wldd22/dodeca-card/images/pcb_back.png

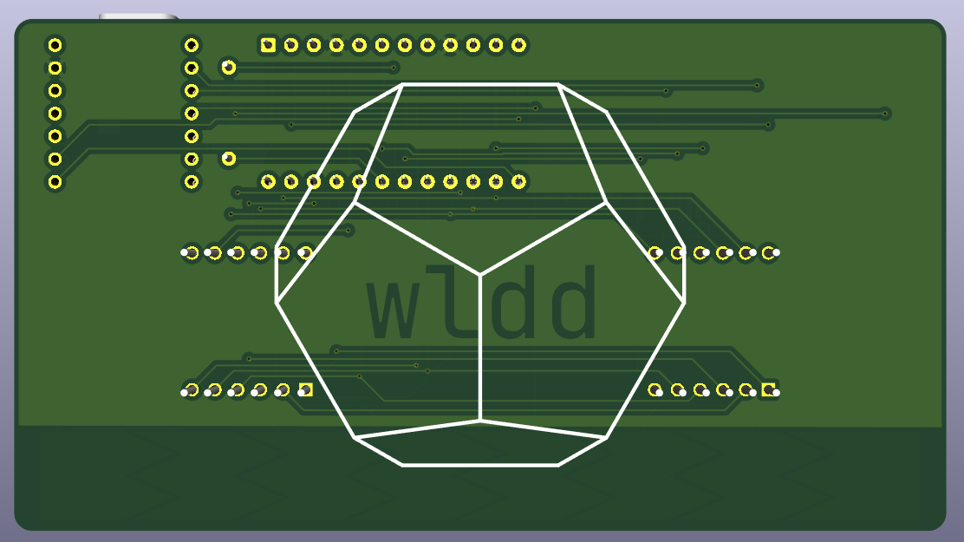
images/pcb_back.png
