wldd22/dodeca-card/BOM.csv

Item | Qty | Supplier | Cost/item | Total Cost | link
PCB | 1 | JLCPCB | $6.90 | $6.90 | https://jlcpcb.com/
MCMF006FF3002A50 30kΩ Through Hole Resistor | 11 | Robu | $0.01 | $0.11 | https://robu.in/product/mcmf006ff3002a50-multicomp-pro-through-hole-resistor-30-kohm-mcmf-series-600-mw-%C2%B1-1-axial-leaded-250-v/
MAX7219-HLF-5V | 1 | Robu | $0.75 | $0.75 | https://robu.in/product/1-month-warranty-851/
0.56 inch 4 Digit 7 Segment Display (2 pcs.) | 1 | Robu | $0.73 | $0.73 | https://robu.in/product/0-56-inch-red-4-digit-7-segment-led-display-cc-12pin/
Seeed Studio XIAO ESP32S3 | 1 | Robu | $12.03 | $12.03 | https://robu.in/product/seeed-studio-xiao-esp32s3-2-4ghz-wifi-ble-5-0/
Estimated total shipping | 1 |  |  | $9.86
