wldd22/dodeca-card/pcb/dodeca-card.kicad_pcb

## KiCad design pcb/dodeca-card.kicad_pcb (2026-11-06)

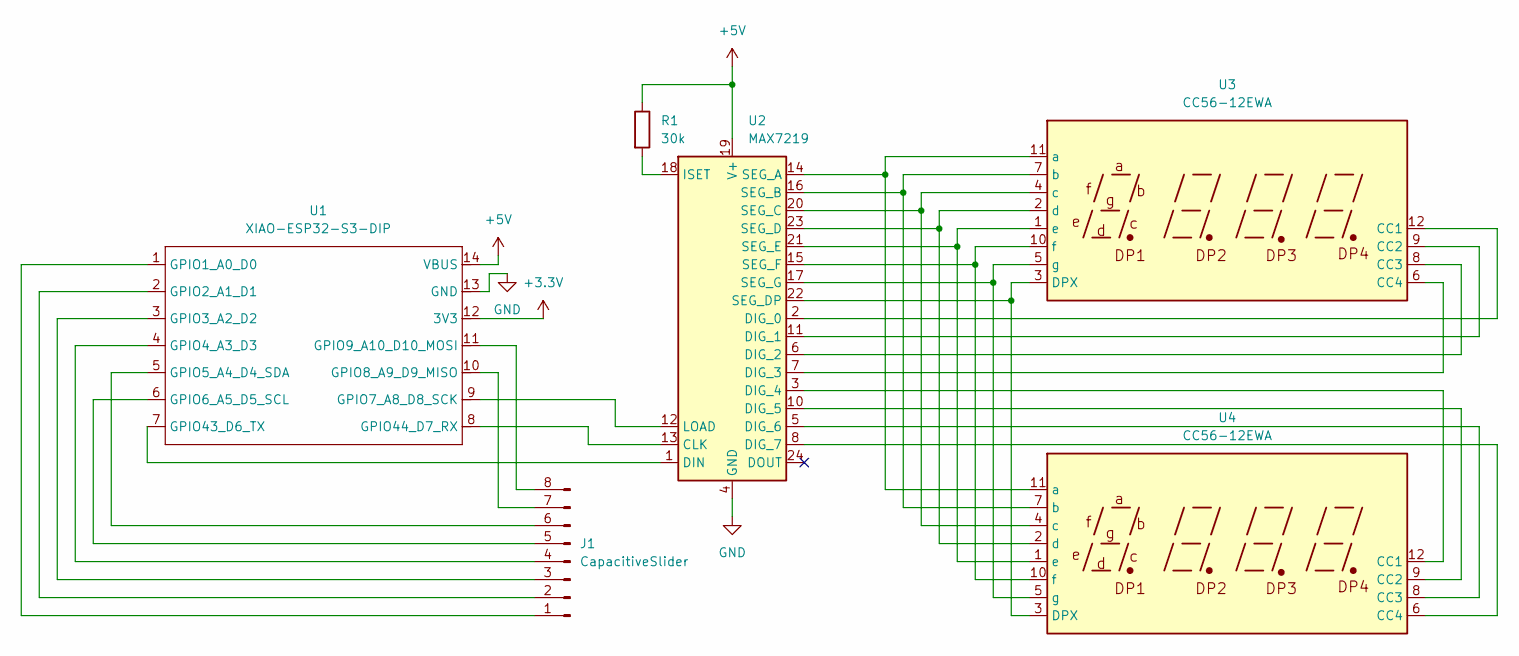
[picture p6: schematic dodeca-card.kicad_sch]

Parts:
J1: CapacitiveSlider; TouchSlider-8
R1: 30k; R_Axial_DIN0207_L6.3mm_D2.5mm_P10.16mm_Horizontal
U1: XIAO-ESP32-S3-DIP
U2: MAX7219; DIP-24_W15.24mm
U3, U4: CC56-12EWA; CA56-12EWA

Connections:
+3.3V: U1.12 (3V3)
+5V: R1.1, U1.14 (VBUS), U2.19 (V+)
GND: U1.13 (GND), U2.4 (GND), U2.9 (GND)
unnamed: J1.1, U1.1 (GPIO1_A0_D0)
unnamed: J1.2, U1.2 (GPIO2_A1_D1)
unnamed: J1.3, U1.3 (GPIO3_A2_D2)
unnamed: J1.4, U1.4 (GPIO4_A3_D3)
unnamed: J1.5, U1.6 (GPIO6_A5_D5_SCL)
unnamed: J1.6, U1.5 (GPIO5_A4_D4_SDA)
unnamed: J1.7, U1.10 (GPIO8_A9_D9_MISO)
unnamed: J1.8, U1.11 (GPIO9_A10_D10_MOSI)
unnamed: U1.9 (GPIO7_A8_D8_SCK), U2.12 (LOAD)
unnamed: U1.7 (GPIO43_D6_TX), U2.1 (DIN)
unnamed: U1.8 (GPIO44_D7_RX), U2.13 (CLK)
unnamed: U2.2 (DIG_0), U3.12 (CC1)
unnamed: U2.11 (DIG_1), U3.9 (CC2)
unnamed: U2.6 (DIG_2), U3.8 (CC3)
unnamed: U2.7 (DIG_3), U3.6 (CC4)
unnamed: U2.3 (DIG_4), U4.12 (CC1)
unnamed: U2.10 (DIG_5), U4.9 (CC2)
unnamed: U2.5 (DIG_6), U4.8 (CC3)
unnamed: U2.8 (DIG_7), U4.6 (CC4)
unnamed: R1.2, U2.18 (ISET)
unnamed: U2.14 (SEG_A), U3.11 (a), U4.11 (a)
unnamed: U2.16 (SEG_B), U3.7 (b), U4.7 (b)
unnamed: U2.20 (SEG_C), U3.4 (c), U4.4 (c)
unnamed: U2.23 (SEG_D), U3.2 (d), U4.2 (d)
unnamed: U2.22 (SEG_DP), U3.3 (DPX), U4.3 (DPX)
unnamed: U2.21 (SEG_E), U3.1 (e), U4.1 (e)
unnamed: U2.15 (SEG_F), U3.10 (f), U4.10 (f)
unnamed: U2.17 (SEG_G), U3.5 (g), U4.5 (g)

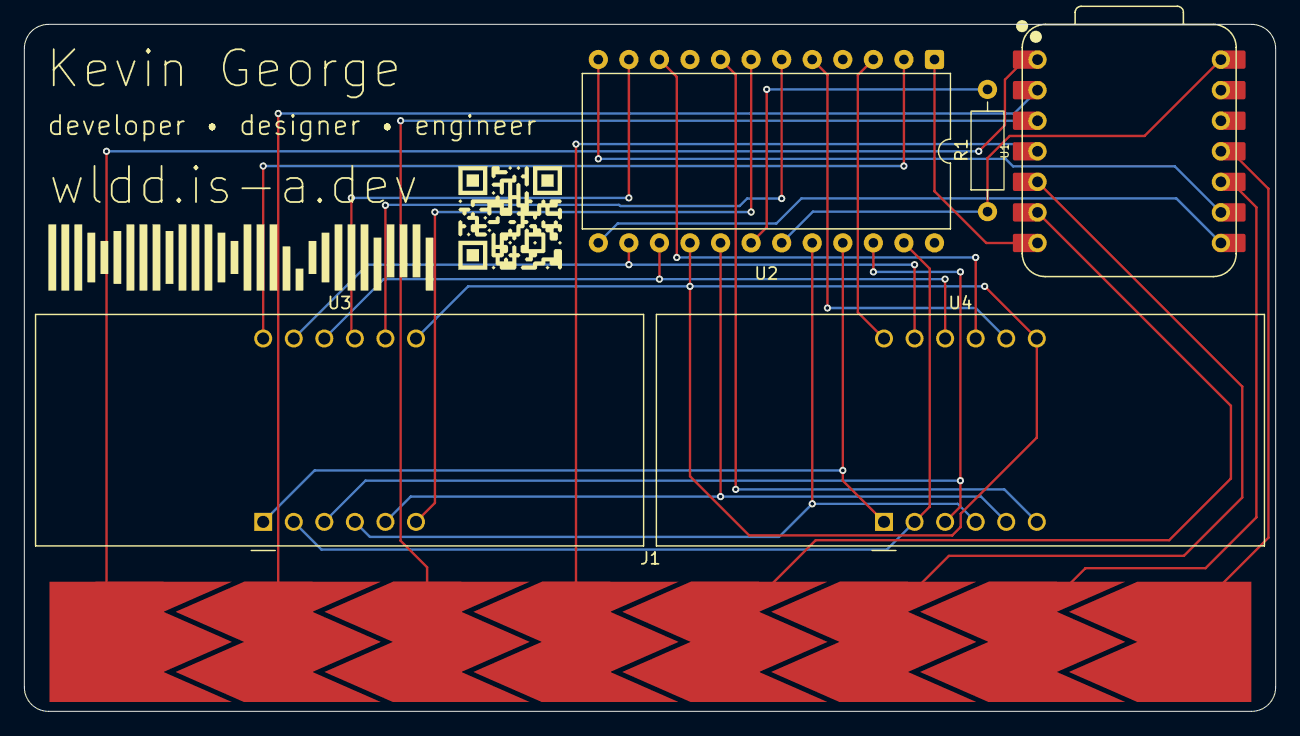
[picture p7: board dodeca-card.kicad_pcb from above]

Board: 2 copper layers, 104.0 x 57.1 mm, 6 parts (0 on the bottom side), 30 nets.
