wldd22/dodeca-card/JOURNAL.md

# Dodeca Card: devlog

<!-- Generated by Half Life from project pv84cxeni457shh4h0gymyvd. Edits here are overwritten on the next sync. -->
<!-- Generated: 2026-11-01T17:32:04.002Z -->

> [!NOTE]
> This devlog is mirrored from [Half Life](https://halflife.hackclub.com) ([open the project](https://halflife.hackclub.com/projects/pv84cxeni457shh4h0gymyvd)). Editing it here will not change the platform's copy, and the next sync overwrites this file.

> A stylised business card with a capacitive slider and two segmented displays to show live information.

| Week | Tier | Hours logged | Entries |
| --- | --- | --- | --- |
| Week 4 | Tier 1 | 13.3h | 5 |

## Contents

1. [2026-10-29: First I planned out the project. I want to have a small business card style board with a segmented display at the bottom. It could show live stats based on web requests (like github stars or some othe](#2026-10-29-first-i-planned-out-the-project-i-want-to-have-a-)
2. [2026-10-30: I did some boring work:](#2026-10-30-i-did-some-boring-work)
3. [2026-10-31: First I did some research online and got some advice from the Slack to improve the routing. Then I rerouted the board again.](#2026-10-31-first-i-did-some-research-online-and-got-some-adv)
4. [2026-11-01: Just adding some finishing touches to the PCB now. I decided on and added some text on F.Silkscreen, along with a QR code and a stylised wordmark. I spent some time calculating positions and distances](#2026-11-01-just-adding-some-finishing-touches-to-the-pcb-now)
5. [2026-11-01: Last entry of week 4!](#2026-11-01-last-entry-of-week-4)

## Design

### 2026-10-29: First I planned out the project. I want to have a small business card style board with a segmented display at the bottom. It could show live stats based on web requests (like github stars or some othe

**3h**

First I planned out the project. I want to have a small business card style board with a segmented display at the bottom. It could show live stats based on web requests (like github stars or some other cool statistic) or updating text with whatever data.

After searching for components, reading some datasheets, and some brief research, I decided on the following parts list:
- 1x Seeed Studio XIAO ESP32C3 (MCU)
- 2x Generic 0.56 inch Red 4 Digit 7 Segment LED Displays
- 1x MAX7219 chip (display driver)

I then created an approximate layout of the parts on a board, just to make sure the dimensions and proportions were about right and how I'd like:

Rough layout plan

Finally, I setup KiCad to work with all the components I planned and made a simple schematic, just hooking up the microcontroller with the MAX7219 chip and the displays.

schematic

I wanna start the PCB layout before finalising the schematic, in case I want to make any changes or additions. Also, since I have so many extra GPIOs, it feels like a waste to not put them to some use. So, I'm considering adding a fancy capacitive slider using one of KiCad's footprint generators, looking something like this:

slider

### 2026-10-30: I did some boring work:

**2.83h**

I did some boring work:
- Found the Rset resistor on Robu and set up its footprint (After deciding on 30kΩ based on the MAX7219 datasheet)
- Set up the remaining 3D models needed

And then the interesting part. I rearranged the board layout more, finalised the layout (I think) and the board size and stuff. I also made the touch slider footprint with KiCad's footprint wizard. Then I attempted the routing, but I'm definitely going to redo it or at least make significant changes to it, since it's currently really messy. This layout is probably the most convoluted routing I've had to do in KiCad before, mostly because of the seemingly random pin definitions for the displays and the MAX7219 chip. I already scrapped and redid it partially a few times and rearranged the schematic in between too. The timelapse really doesn't do justice to the amount of back and forth I had to do.
schematic
routing

Hopefully next time I try routing the board I'll learn from my mistakes and improve (and by that I mean the copper gods won't curse me with having to use this many random vias again)

[Timelapse](https://lookout.hackclub.com/api/media/01cc2f07-4372-4b25-89cc-aa4790cbe740/video.mp4)

### 2026-10-31: First I did some research online and got some advice from the Slack to improve the routing. Then I rerouted the board again.

**2.22h**

First I did some research online and got some advice from the Slack to improve the routing. Then I rerouted the board again.

Before:
Old routing

After
New routing

You may have noticed I also moved the GND plane from F.Cu to B.Cu.

Then I added some graphics to the board. A dodeca logo on B.Silkscreen and a wordmark on B.Cu. The wordmark is actually a rule area keepout that excludes the zone fill. I had to add extra zone fills to create the isolated copper islands for the counters in the "d"s. That took a bit of figuring out.

This is what the final board looks like:

With graphics

I'm still gonna add more silkscreen graphics to the board, so it's not completely done yet.

[Timelapse](https://lookout.hackclub.com/api/media/abc4e7c7-58dd-4748-879b-3329161a8d35/video.mp4)

### 2026-11-01: Just adding some finishing touches to the PCB now. I decided on and added some text on F.Silkscreen, along with a QR code and a stylised wordmark. I spent some time calculating positions and distances

**1.25h**

Just adding some finishing touches to the PCB now. I decided on and added some text on F.Silkscreen, along with a QR code and a stylised wordmark. I spent some time calculating positions and distances and aligning each element to ensuring everything was distributed properly. I also rounded the Edge.Cuts. Now, the board looks like this:

PCB

Then I added some images to the repo and generated the board's gerber files.

Next, I created the BOM for the project:

BOM

Since I especially picked really cheap components, I was able to get the total cost just under $30 including shipping. I only need 1 resistor, but Robu won't let me buy only one because its cost is too low, so I'm buying 10 instead (It only costs an additional $0.09).

Next, I'll write the README and some simple firmware.

### 2026-11-01: Last entry of week 4!

**4h**

Last entry of week 4!

First thing I did was make the firmware. It only handles the display right now and shows some dummy text to test it's working properly.

I discovered that I won't be able to use the standard touch sensing library because the XIAO ESP32-C3 doesn't actually support touch sensing. But, no need for panic, I don't have to switch microcontrollers, because I've found there *are* ways (albeit complex and with some downsides) to still have touch sensing using the chip's pull-up functionality. It's kinda hard to plan and design that right now though, since I can't test with the board at all. So, I'll do that in the build week.

Also, the firmware includes a segments dict for each possible character. I probably could've found a list online, but I wanted full control over the look of the letters. So, armed with some screenshots of [segmented displays from Wikipedia](https://en.wikipedia.org/wiki/Seven-segment_display_character_representations) and a diagram from [the datasheet](https://robu-prod-media.s3.ap-south-1.amazonaws.com/products/attachments/vhLsh0cFfzyxSN4LQugApwKgnfJNADV1g4lqE36g.pdf), I wrote it out it manually.

Segmented displays
Here's what the firmware looks like:

Firmware 1

Firmware 2

Firmware 3

Firmware 4

Firmware 5

Firmware 6

Firmware 7

Finally, I wrote a detailed README for the project.
