wldd22/dodeca-card/(commit log)

2026-10-30 Sync Dodeca Card from Half Life
    [BOM.csv]
2026-10-30 Update schematic and board
    [Seeed Studio XIAO-ESP32-C3.step, dodeca-card.kicad_pcb, dodeca-card.kicad_sch]
2026-11-01 Add silkscreen graphics
    [dodeca-card.kicad_pcb]
2026-11-01 Generate gerber files
    [dodeca-card-B_Cu.gbr, dodeca-card-B_Mask.gbr, dodeca-card-B_Paste.gbr, dodeca-card-B_Silkscreen.gbr, dodeca-card-Edge_Cuts.gbr, dodeca-card-F_Cu.gbr, dodeca-card-F_Mask.gbr, dodeca-card-F_Paste.gbr]
2026-11-04 Change ESP32-C3 to ESP32-S3
    [dodeca-card.kicad_pcb, dodeca-card.kicad_sch]
2026-11-04 Regenerate gerber files
    [dodeca-card-B_Cu.gbr, dodeca-card-B_Mask.gbr, dodeca-card-B_Paste.gbr, dodeca-card-B_Silkscreen.gbr, dodeca-card-Edge_Cuts.gbr, dodeca-card-F_Cu.gbr, dodeca-card-F_Mask.gbr, dodeca-card-F_Paste.gbr]
2026-11-06 Change routing
    [dodeca-card.kicad_pcb, dodeca-card.kicad_sch]
